saadafsy/p2-riscv-soc/fpga/basys3.xdc

## Basys 3 (xc7a35tcpg236-1) constraints for fpga/basys3_top.sv.
## Pins from Digilent's Basys-3-Master.xdc.

set_property -dict { PACKAGE_PIN W5  IOSTANDARD LVCMOS33 } [get_ports clk100]
create_clock -name sys_clk -period 10.000 [get_ports clk100]

# MMCM outputs: CLKOUT1 = SoC (62.5 MHz), CLKOUT0 = accelerator (50 MHz).
# They meet only in the gray-pointer CDC FIFOs and 2-flop synchronizers:
# bound the crossing paths by the faster period instead of timing them as
# synchronous.
set soc_clk   [get_clocks -of_objects [get_pins u_mmcm/CLKOUT1]]
set accel_clk [get_clocks -of_objects [get_pins u_mmcm/CLKOUT0]]
set_max_delay -datapath_only -from $soc_clk -to $accel_clk 16.000
set_max_delay -datapath_only -from $accel_clk -to $soc_clk 16.000

# JTAG TCK from BSCANE2 (debug transport, rtl/debug): its own clock, at most
# about 30 MHz on the Digilent cable. It meets the SoC clock only in the
# cdc_req_ack toggle handshake; the held request/response words are bounded
# by one SoC period (rtl/debug/README.md).
create_clock -name jtag_tck -period 33.333 [get_pins -hierarchical -filter {NAME =~ *u_bscan/TCK}]
set_max_delay -datapath_only -from [get_clocks jtag_tck] -to $soc_clk 16.000
set_max_delay -datapath_only -from $soc_clk -to [get_clocks jtag_tck] 16.000

## Buttons (btnC is the reset)
set_property -dict { PACKAGE_PIN U18 IOSTANDARD LVCMOS33 } [get_ports btn_c]
set_property -dict { PACKAGE_PIN T18 IOSTANDARD LVCMOS33 } [get_ports btn_u]
set_property -dict { PACKAGE_PIN W19 IOSTANDARD LVCMOS33 } [get_ports btn_l]
set_property -dict { PACKAGE_PIN T17 IOSTANDARD LVCMOS33 } [get_ports btn_r]
set_property -dict { PACKAGE_PIN U17 IOSTANDARD LVCMOS33 } [get_ports btn_d]

## Switches
set_property -dict { PACKAGE_PIN V17 IOSTANDARD LVCMOS33 } [get_ports {sw[0]}]
set_property -dict { PACKAGE_PIN V16 IOSTANDARD LVCMOS33 } [get_ports {sw[1]}]
set_property -dict { PACKAGE_PIN W16 IOSTANDARD LVCMOS33 } [get_ports {sw[2]}]
set_property -dict { PACKAGE_PIN W17 IOSTANDARD LVCMOS33 } [get_ports {sw[3]}]
set_property -dict { PACKAGE_PIN W15 IOSTANDARD LVCMOS33 } [get_ports {sw[4]}]
set_property -dict { PACKAGE_PIN V15 IOSTANDARD LVCMOS33 } [get_ports {sw[5]}]
set_property -dict { PACKAGE_PIN W14 IOSTANDARD LVCMOS33 } [get_ports {sw[6]}]
set_property -dict { PACKAGE_PIN W13 IOSTANDARD LVCMOS33 } [get_ports {sw[7]}]
set_property -dict { PACKAGE_PIN V2  IOSTANDARD LVCMOS33 } [get_ports {sw[8]}]
set_property -dict { PACKAGE_PIN T3  IOSTANDARD LVCMOS33 } [get_ports {sw[9]}]
set_property -dict { PACKAGE_PIN T2  IOSTANDARD LVCMOS33 } [get_ports {sw[10]}]
set_property -dict { PACKAGE_PIN R3  IOSTANDARD LVCMOS33 } [get_ports {sw[11]}]
set_property -dict { PACKAGE_PIN W2  IOSTANDARD LVCMOS33 } [get_ports {sw[12]}]
set_property -dict { PACKAGE_PIN U1  IOSTANDARD LVCMOS33 } [get_ports {sw[13]}]
set_property -dict { PACKAGE_PIN T1  IOSTANDARD LVCMOS33 } [get_ports {sw[14]}]
set_property -dict { PACKAGE_PIN R2  IOSTANDARD LVCMOS33 } [get_ports {sw[15]}]

## LEDs
set_property -dict { PACKAGE_PIN U16 IOSTANDARD LVCMOS33 } [get_ports {led[0]}]
set_property -dict { PACKAGE_PIN E19 IOSTANDARD LVCMOS33 } [get_ports {led[1]}]
set_property -dict { PACKAGE_PIN U19 IOSTANDARD LVCMOS33 } [get_ports {led[2]}]
set_property -dict { PACKAGE_PIN V19 IOSTANDARD LVCMOS33 } [get_ports {led[3]}]
set_property -dict { PACKAGE_PIN W18 IOSTANDARD LVCMOS33 } [get_ports {led[4]}]
set_property -dict { PACKAGE_PIN U15 IOSTANDARD LVCMOS33 } [get_ports {led[5]}]
set_property -dict { PACKAGE_PIN U14 IOSTANDARD LVCMOS33 } [get_ports {led[6]}]
set_property -dict { PACKAGE_PIN V14 IOSTANDARD LVCMOS33 } [get_ports {led[7]}]
set_property -dict { PACKAGE_PIN V13 IOSTANDARD LVCMOS33 } [get_ports {led[8]}]
set_property -dict { PACKAGE_PIN V3  IOSTANDARD LVCMOS33 } [get_ports {led[9]}]
set_property -dict { PACKAGE_PIN W3  IOSTANDARD LVCMOS33 } [get_ports {led[10]}]
set_property -dict { PACKAGE_PIN U3  IOSTANDARD LVCMOS33 } [get_ports {led[11]}]
set_property -dict { PACKAGE_PIN P3  IOSTANDARD LVCMOS33 } [get_ports {led[12]}]
set_property -dict { PACKAGE_PIN N3  IOSTANDARD LVCMOS33 } [get_ports {led[13]}]
set_property -dict { PACKAGE_PIN P1  IOSTANDARD LVCMOS33 } [get_ports {led[14]}]
set_property -dict { PACKAGE_PIN L1  IOSTANDARD LVCMOS33 } [get_ports {led[15]}]

## USB-UART bridge (RsRx B18 host -> FPGA, RsTx A18 FPGA -> host)
set_property -dict { PACKAGE_PIN B18 IOSTANDARD LVCMOS33 } [get_ports uart_rx]
set_property -dict { PACKAGE_PIN A18 IOSTANDARD LVCMOS33 } [get_ports uart_tx]

set_property CFGBVS VCCO [current_design]
set_property CONFIG_VOLTAGE 3.3 [current_design]

## Buttons, switches and UART RX are synchronized inside the design.
set_false_path -from [get_ports {btn_* sw[*] uart_rx}]
set_false_path -to [get_ports {led[*] uart_tx}]
