saadafsy/p2-riscv-soc/(commit log)

2026-11-09 SoC infrastructure: spec, golden ISS, software, APB4 bus and peripherals, lockstep testbench
    - docs/spec.md: interface contract (ISA subset, OBI, APB4, memory map).
    - model/: RV32I+Zicsr M-mode instruction-set simulator (218 pytest), random program generator.
    - sw/: crt0, linker script, drivers, 10 self-checking ISA tests, C demos and a CRC/matrix benchmark.
    - rtl/: dual-port BRAM, OBI decoder, OBI-to-APB4 bridge, UART/GPIO/timer/simctrl, OBI and APB SVA checkers.
    - tb/periph: 53 cocotb tests incl. checker negative tests; formal/bus_bmc.sby BMC with covers.
    - tb/soc: soc_top lockstep against the ISS on every program.
    - fpga/: Basys 3 top, constraints, Vivado build script (not yet run).
2026-11-09 JTAG debug port and March C- memory BIST (standalone, verified)
    - rtl/debug: IEEE 1149.1 TAP (IDCODE, BYPASS, user DR), toggle req/ack CDC,
    66-bit debug DR mastering the OBI bus (READ/WRITE/STATUS), BSCANE2 wrapper
    for the Basys 3 USB-JTAG (Vivado only, untested in sim).
    - rtl/dft: March C- MBIST as an OBI master with fail address/element/background.
    - tb: 11 debug tests (all TAP states and transitions, three tck/clk ratios,
    random bus latency), 16 MBIST runs with injected stuck-at, transition,
    coupling and address faults vs a reference model.
    - formal: TAP reset proved by k-induction; CDC handshake BMC (no lost or
    duplicated request).
    [debug_cdc_top.sv, debug_tap_top.sv, fault_mem.sv, march_ref.py, mbist_marchc.sv, run.py, tb_mbist.sv, test_mbist.py]
2026-11-09 UVM environment for the APB4 subsystem; fix UART bit timer after a divisor drop
    - tb/uvm: OBI agent (randomized timing), passive APB monitor, cycle-exact
    register predictor (byte lanes, action registers, UART TX FIFO/shifter,
    mtime), scoreboard on every APB transfer and OBI response, SV covergroups,
    bound OBI/APB protocol checkers. Regression: 11 runs over 5 seeds, 0
    mismatches; merged covergroup bins 337/337, RTL line 97.8%. make bug:
    three injected bugs, all caught.
    - uart_apb: TX/RX bit timers compare with >= so lowering DIVISOR mid-character
    ends the bit instead of wrapping the 16-bit counter (found by the UVM
    random test); predictor updated to match.
    [apb_if.sv, apb_sub_binds.sv, apb_sub_wrap.sv, obi_agent.sv, obi_if.sv, obi_item.sv, p2_coverage.sv]
2026-11-09 RV32I + Zicsr core: 5-stage pipeline, M-mode traps and interrupts, RVFI
    rtl/core: fetch (2-entry queue), decoder, ALU, regfile (write-through),
    CSR, hazard unit and the pipeline top: forwarding from EX/MEM and MEM/WB,
    one-cycle load-use stall, branches resolved in EX (not-taken prediction),
    precise traps committed at MEM -> WB, direct-mode mtvec, MTIP/MEIP, RVFI
    trace port. tb/core: 41 cocotb tests against a Python reference, CPI
    checks included; formal/core_bmc: BMC on pipeline invariants plus covers.
    synth/: sky130 timing-driven synthesis and STA (about 113 MHz at the
    typical corner) and the Artix-7 resource summary.
    [core_bmc.sv, rv32_alu.sv, rv32_core.sv, rv32_csr.sv]
2026-11-09 Attention accelerator from P1 as an AXI4-Lite peripheral in its own clock domain
    - rtl/accel: axil_attn (register map, AXI4-Lite with full handshakes),
    attn_seq (drives attention_top on accel_clk), async_fifo (gray pointers,
    2-flop synchronizers) for commands, read data and DONE + cycle count.
    rtl/accel/p1 is a byte-identical copy of p1-attention 86d497c
    (make -C tb/accel check compares it).
    - obi_decoder AXI_EN, obi2axil bridge; accelerator irq ORed into MEIP.
    - sw: accel driver and attn_test (N = 4, 16, 64; N = 16 by interrupt),
    outputs equal the fixed-point C model and P1's Python model.
    - tb/accel: 5 tests with back-pressure on every channel, at accelerator
    clocks of 73 and 1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
    [accel.c, accel.h, accel_fifo_top.sv, async_fifo.sv, attn_seq.sv, attn_test.c, axil_attn.sv]
2026-11-09 Physical design: OpenROAD-flow-scripts RTL-to-GDS for rv32_core on sky130hd
    pd/run_orfs.sh runs the flow in the openroad/orfs image. rv32_core at 10 ns:
    setup WNS +1.36 ns (116 MHz signoff), hold +0.45 ns, 0 DRC, 0 antenna,
    17.6k cells, 18.7 mW.
2026-11-09 Integrate JTAG debug, core hold, RAM BIST and accelerator clock gate into soc_top
    Spec section 13 first. obi_arb2 shares the data bus between the core and
    the JTAG master (round-robin, choice locked while a request waits for its
    grant). SYSCTL at APB slot 3 holds the core in reset, starts the March C-
    BIST on the data RAM (only while the core is held; port B goes through
    bist_ram_mux) and enables the accelerator clock. clk_gate is an ICG:
    sky130 dlclkp, BUFGCE, or a behavioral latch model. The FPGA define is
    FPGA_XC7, since p1's RTL already uses XILINX_FPGA for an XPM ROM.
    rtl/soc.f lists the SoC sources outside rtl/core.
    [bist_ram_mux.sv, clk_gate.sv, obi_arb2.sv, soc_top.sv, sysctl_apb.sv]
2026-11-09 Tests for the debug fabric: SoC-level cocotb bench, arbiter formal, clkgate_test
    tb/socdbg runs soc_top with OBI checkers on every new link: JTAG traffic
    while bench runs in lockstep, JTAG program load and boot, BIST pass and
    stuck-at fail, and clkgate_test with a gated-clock edge monitor and the
    frozen run checked against p1 attn_fixed. formal/arb_bmc.sby: BMC and
    cover on obi_arb2. The lockstep bench drives the JTAG pins idle and is
    split into reset and check helpers for reuse; it reads rtl/soc.f.
    tb/socdbg/lint.sh and synth.sh cover the new blocks, soc_top and the
    board top (primitive stubs); exactly one latch, the ICG model.
    [arb_formal_top.sv, clkgate_test.c, run.py, sky130_icg.sv, soc.h, tb_soc_dbg.sv, test_soc_dbg.py]
2026-11-09 Basys 3: JTAG over BSCANE2, power-on-only debug reset, BUFGCE clock gate
    Both flows read rtl/core/core.f and rtl/soc.f and define FPGA_XC7. The
    XDC constrains the BSCANE2 TCK (Vivado only; the openXC7 filter keeps
    port clocks). Not built or run on the board in this change.
    [basys3.xdc, basys3_top.sv]
2026-11-09 DFT: scan-chain insertion and SAT-based stuck-at ATPG on sky130 netlists
    dft/run_fault.sh: yosys to sky130 cells, liberty-derived cell models,
    fault cut, nl2bench + quaigh ATPG with compaction, fault chain with a
    simulated shift check. Peripherals: gpio 93.6%, timer 95.3%, uart 99.3%
    collapsed stuck-at coverage; all three chains verified. pd/run_orfs.sh
    picks a docker CLI that reaches a daemon.
2026-11-09 M extension: spec, golden ISS, ISA test, rv32im_zicsr toolchain
    Spec section 2/3: MUL/MULH/MULHSU/MULHU/DIV/DIVU/REM/REMU semantics
    including divide-by-zero and overflow results, misa = 0x40001100, EX
    latency and stall rules. ISS implements M; pytest cases for every corner.
    sw/isa/muldiv.S self-checks all ops; trap.S uses funct7 = 2 for its
    illegal OP case. Software builds for rv32im_zicsr (MARCH= to override).
    randgen emits M instructions (zero divisors, dependent pairs).
    [randgen.py, rv32_iss.py]
2026-11-09 M extension in the core: rv32_muldiv in EX
    Multiply in 4 EX cycles (registered operands per partial product, four
    17x17 partials, carry-save add and word select), divide/remainder in 34
    (radix-2 restoring). EX holds until done; operands come from the unit's
    own registered forwarding selects; a pending interrupt abandons the
    operation and the instruction re-executes after MRET. Formal: M unit
    progress asserts, busy only with an M op in EX, gap bound excludes M
    cycles, covers for an M retire and an interrupted M op. tb/core: muldiv,
    md_irq, md_irq_noise tests, M rates in test_cpi, muldiv ISA test.
2026-11-09 CoreMark port for the SoC; results with and without M
    third_party/coremark: eembc/coremark at 1f483d5, benchmark sources and
    LICENSE only. sw/coremark: bare-metal core_portme (mtime ticks, SIMCTRL
    PUTC output, exit code from CoreMark's CRC check). sw/Makefile target
    coremark (MARCH=, CM_ITER=). printf accepts the l modifier.
    Lockstep SoC run, 2 iterations: 2.267 CoreMark/MHz with M, 0.962
    without; not an official score (far under 10 s).
2026-11-09 C++ performance model, calibrated against RTL cycle counts
    model/perf/p2perf.cpp: functional RV32IM + Zicsr model with timed UART TX
    FIFO and timer interrupts, plus an event-count pipeline timing model.
    calibrate.py fits the undocumented costs on the directed ISA programs
    (non-negative least squares) and validates on the C programs: hello,
    bench, timer_irq, irq and CoreMark (with and without M) within 0.6% of
    RTL cycles. About 70 M instructions/s.
    [params.txt]
2026-11-09 DFT: rv32_core (RV32IM) scan chain and ATPG, 98.4% stuck-at coverage
2026-11-09 riscv-formal: wrapper (free OBI memory, in-order responses), checks config, runner
    [checks.cfg]
2026-11-09 riscv-formal: RISCV_FORMAL_ALTOPS datapath in rv32_muldiv (formal-only), reg/pc_fwd depth 20, divide checks depth 45
    The substitute M functions keep the unit timing and control, so the checks
    cover decode, operand capture, stalls and writeback of every M op; the
    arithmetic stays covered by the ISS lockstep. Without the define the RTL is
    unchanged (tb/core 53/53, core formal and lint pass).
    [checks.cfg]
2026-11-09 soc_top ACCEL_EN parameter; Basys 3 build without the accelerator
    The full SoC with the attention accelerator needs about 20.7k LUTs in the
    openXC7 flow, the whole of the XC7A35T (20,800), and did not route in two
    seeds. ACCEL_EN = 0 drops the AXI bridge and the accelerator; 0x2000_0000
    then reads 0 like any unmapped range. Default 1 keeps every simulation
    unchanged (lockstep 16/16, socdbg 4/4 at both ratios, lint for both
    settings).
2026-11-09 riscv-formal: all 52 RV32IM checks pass (pc_fwd at depth 15); README
    [checks.cfg]
2026-11-09 Board firmware: attn_test with results on the UART (make -C sw board); lockstep PASS in the SoC testbench
2026-11-09 Board firmware check: decode the UART pin in the SoC testbench (make board)
2026-11-10 Locate p1-attention next to this repo instead of a fixed home path
    [test_soc_dbg.py]
2026-11-10 UVM docs: the UART divisor stall was fixed in RTL (edb90c2); say how it was found
